sunriax/lamp/pcb/pcb.kicad_pcb

## KiCad design pcb/pcb.kicad_pcb (2021-07-28)

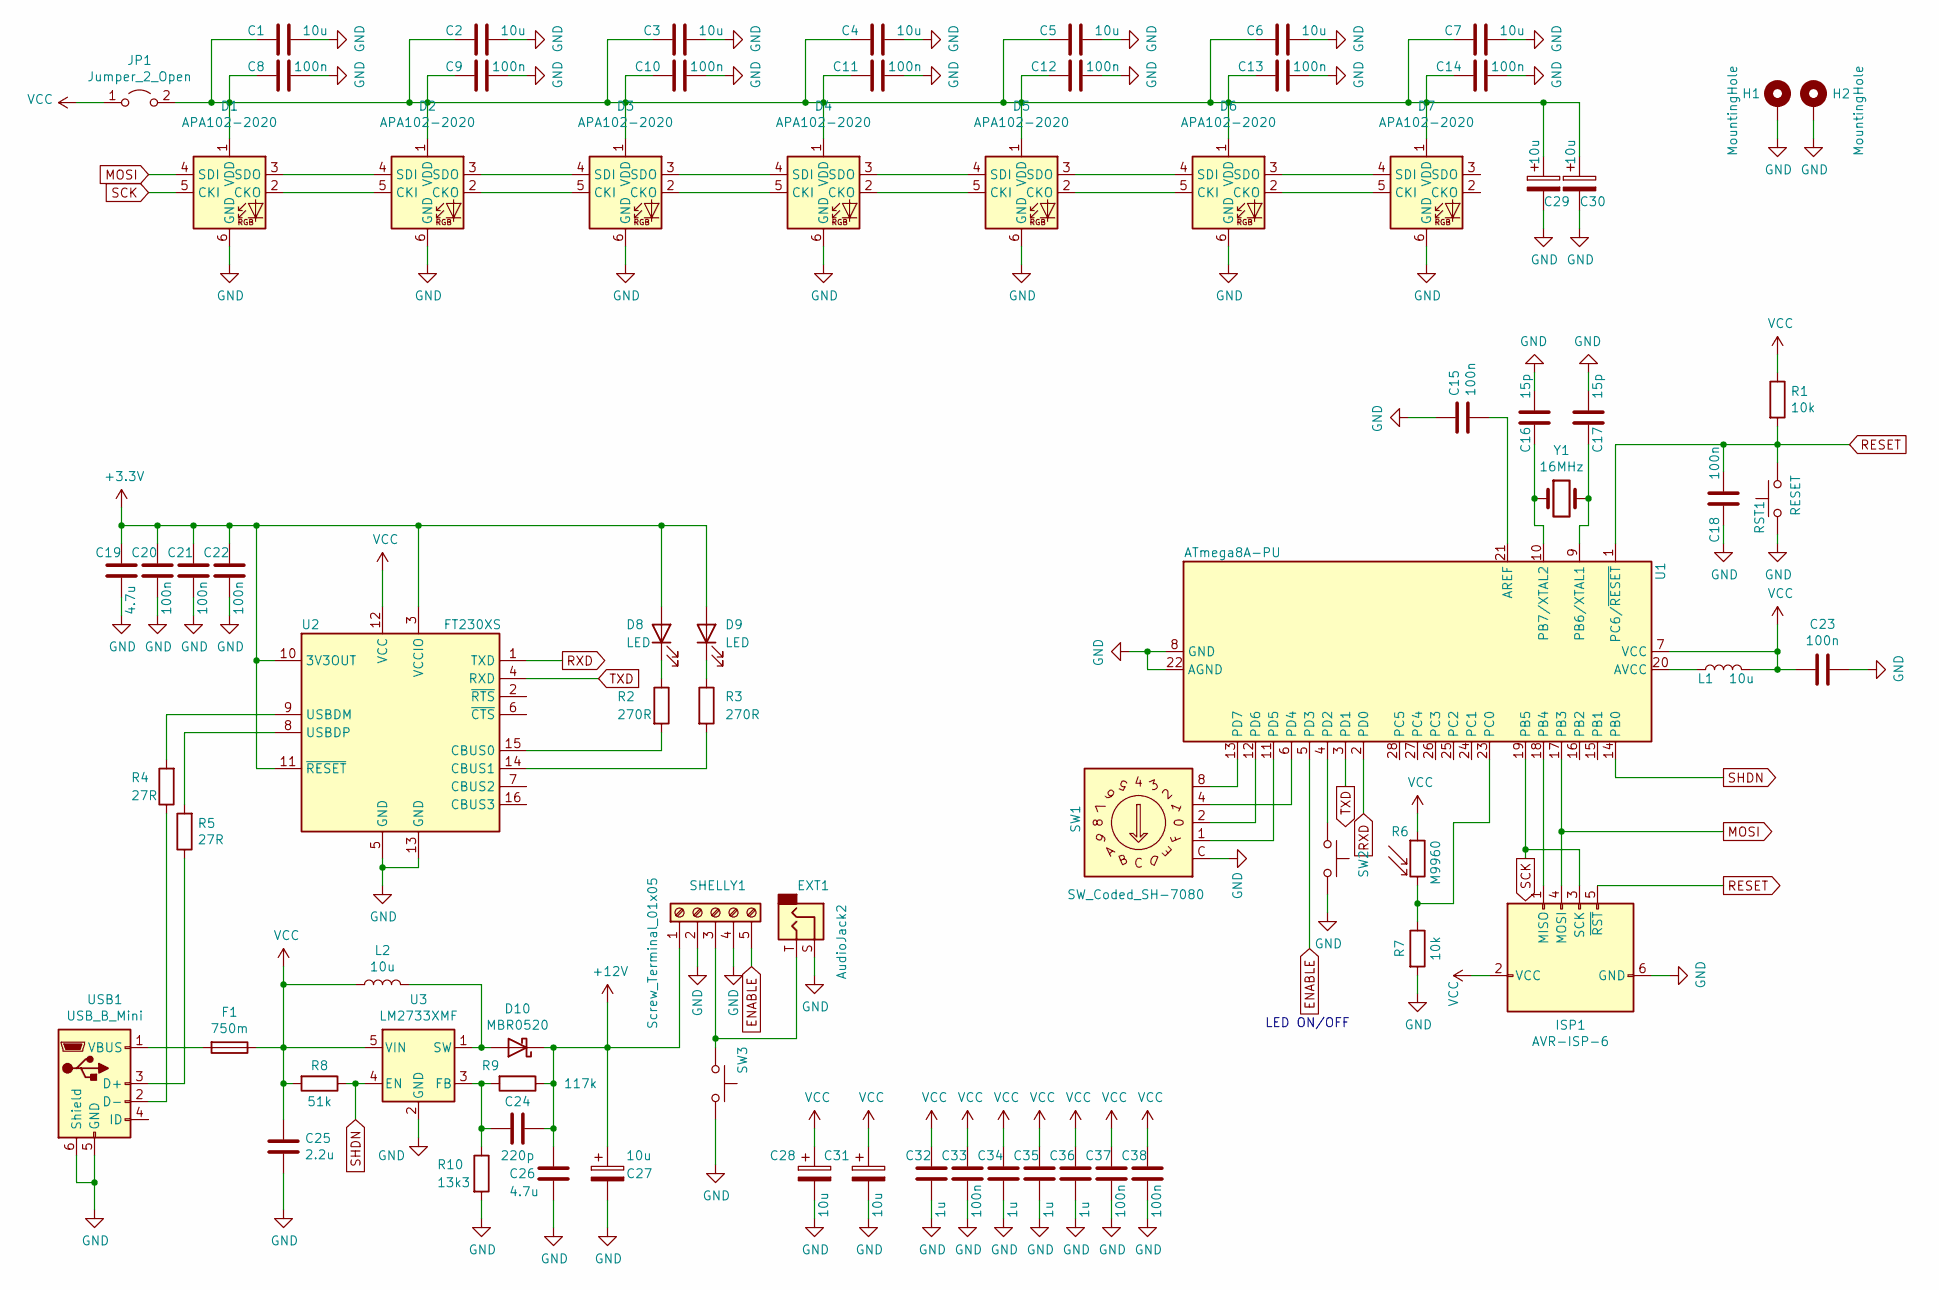
[picture p2: schematic pcb.sch, LED Controller]

Parts:
C1, C2, C3, C4, C5, C6, C7: 10u; C_0603_1608Metric
C8, C9, C10, C11, C12, C13, C14, C15, C18, C20, C21, C22, C23, C33, C37, C38: 100n; C_0603_1608Metric
C16, C17: 15p; C_0603_1608Metric
C19, C26: 4.7u; C_0603_1608Metric
C24: 220p; C_0603_1608Metric
C25: 2.2u; C_0603_1608Metric
C27, C28, C29, C30, C31: 10u; CP_Elec_4x5.8
C32, C34, C35, C36: 1u; C_0603_1608Metric
D1, D2, D3, D4, D5, D6, D7: APA102-2020; LED-APA102-2020
D8, D9: LED; LED_0603_1608Metric
D10: MBR0520; D_SOD-123
EXT1: AudioJack2; Jack_3.5mm_CUI_SJ-3523-SMT_Horizontal
F1: 750m; Fuse_Bourns_MF-SM_7.98x5.44mm
H1, H2: MountingHole; MountingHole_3.2mm_M3_Pad
ISP1: AVR-ISP-6; PinHeader_2x03_P2.54mm_Vertical_SMD
JP1: Jumper_2_Open; PinHeader_1x02_P2.54mm_Horizontal
L1: 10u; L_0805_2012Metric
L2: 10u; L_Bourns-SRN1060
R1, R7: 10k; R_0603_1608Metric
R2, R3: 270R; R_0603_1608Metric
R4, R5: 27R; R_0603_1608Metric
R6: M9960; R_LDR_5.2x5.2mm_P3.5mm_Horizontal
R8: 51k; R_0603_1608Metric
R9: 117k; R_0603_1608Metric
R10: 13k3; R_0603_1608Metric
RST1: RESET; SW_Push_1P1T-SH_NO_CK_KMR2xxG
SHELLY1: Screw_Terminal_01x05; TerminalBlock_Phoenix_MKDS-1,5-5_1x05_P5.00mm_Horizontal
SW1: SW_Coded_SH-7080; Nidec_Copal_SH-7040B
SW2, SW3: SW_Push_1P1T-SH_NO_CK_KMR2xxG
U1: ATmega8A-PU; DIP-28_W8.89mm_SMDSocket_LongPads
U2: FT230XS; SSOP-16_3.9x4.9mm_P0.635mm
U3: LM2733XMF; SOT-23-5
USB1: USB_B_Mini; USB_Mini-B_Lumberg_2486_01_Horizontal
Y1: 16MHz; Crystal_SMD_0603-2Pin_6.0x3.5mm

Connections:
+3V3: C19.2, C20.2, C21.2, C22.2, D8.2 (A), D9.2 (A), U2.3 (VCCIO), U2.10 (3V3OUT), U2.11 (~RESET)
+12V: C24.1, C26.1, C27.1, D10.1 (K), R9.1, SHELLY1.1
ENABLE: SHELLY1.5, U1.5 (PD3)
GND: C1.1, C2.1, C3.1, C4.1, C5.1, C6.1, C7.1, C8.1, C9.1, C10.1, C11.1, C12.1, C13.1, C14.1, C15.2, C16.2, C17.1, C18.2, C19.1, C20.1, C21.1, C22.1, C23.2, C25.2, C26.2, C27.2, C28.2, C29.2, C30.2, C31.2, C32.1, C33.1, C34.1, C35.1, C36.1, C37.1, C38.1, D1.6 (GND), D2.6 (GND), D3.6 (GND), D4.6 (GND), D5.6 (GND), D6.6 (GND), D7.6 (GND), EXT1.S, H1.1, H2.1, ISP1.6 (GND), R7.2, R10.2, RST1.1, SHELLY1.2, SHELLY1.4, SW1.C, SW2.1, SW3.1, U1.8 (GND), U1.22 (AGND), U2.5 (GND), U2.13 (GND), U3.2 (GND), USB1.5 (GND), USB1.6 (Shield)
MOSI: D1.4 (SDI), ISP1.4 (MOSI), U1.17 (PB3)
unnamed: C1.2, C2.2, C3.2, C4.2, C5.2, C6.2, C7.2, C8.2, C9.2, C10.2, C11.2, C12.2, C13.2, C14.2, C29.1, C30.1, D1.1 (VDD), D2.1 (VDD), D3.1 (VDD), D4.1 (VDD), D5.1 (VDD), D6.1 (VDD), D7.1 (VDD), JP1.2 (B)
unnamed: C15.1, U1.21 (AREF)
unnamed: C16.1, U1.10 (PB7/XTAL2), Y1.1
unnamed: C17.2, U1.9 (PB6/XTAL1), Y1.2
unnamed: C24.2, R9.2, R10.1, U3.3 (FB)
unnamed: D1.2 (CKO), D2.5 (CKI)
unnamed: D1.3 (SDO), D2.4 (SDI)
unnamed: D2.2 (CKO), D3.5 (CKI)
unnamed: D2.3 (SDO), D3.4 (SDI)
unnamed: D3.2 (CKO), D4.5 (CKI)
unnamed: D3.3 (SDO), D4.4 (SDI)
unnamed: D4.2 (CKO), D5.5 (CKI)
unnamed: D4.3 (SDO), D5.4 (SDI)
unnamed: D5.2 (CKO), D6.5 (CKI)
unnamed: D5.3 (SDO), D6.4 (SDI)
unnamed: D6.2 (CKO), D7.5 (CKI)
unnamed: D6.3 (SDO), D7.4 (SDI)
unnamed: D8.1 (K), R2.1
unnamed: D9.1 (K), R3.1
unnamed: D10.2 (A), L2.2, U3.1 (SW)
unnamed: EXT1.T, SHELLY1.3, SW3.2
unnamed: F1.2, USB1.1 (VBUS)
unnamed: ISP1.1 (MISO), U1.18 (PB4)
unnamed: L1.1, U1.20 (AVCC)
unnamed: R2.2, U2.15 (CBUS0)
unnamed: R3.2, U2.14 (CBUS1)
unnamed: R4.1, USB1.2 (D-)
unnamed: R4.2, U2.9 (USBDM)
unnamed: R5.1, USB1.3 (D+)
unnamed: R5.2, U2.8 (USBDP)
unnamed: R6.2, R7.1, U1.23 (PC0)
unnamed: SW1.1, U1.11 (PD5)
unnamed: SW1.2, U1.12 (PD6)
unnamed: SW1.4, U1.6 (PD4)
unnamed: SW1.8, U1.13 (PD7)
unnamed: SW2.2, U1.4 (PD2)
RESET: C18.1, ISP1.5 (~RST), R1.2, RST1.2, U1.1 (PC6/~RESET)
RXD: U1.2 (PD0), U2.1 (TXD)
SCK: D1.5 (CKI), ISP1.3 (SCK), U1.19 (PB5)
SHDN: R8.1, U1.14 (PB0), U3.4 (EN)
TXD: U1.3 (PD1), U2.4 (RXD)
VCC: C23.1, C25.1, C28.1, C31.1, C32.2, C33.2, C34.2, C35.2, C36.2, C37.2, C38.2, F1.1, ISP1.2 (VCC), JP1.1 (A), L1.2, L2.1, R1.1, R6.1, R8.2, U1.7 (VCC), U2.12 (VCC), U3.5 (VIN)

Notes on the sheet:
LED ON/OFF

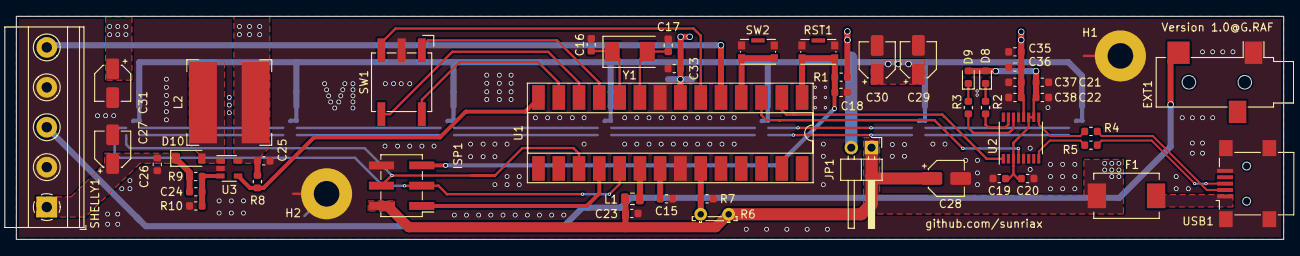
[picture p3: board pcb.kicad_pcb from above]

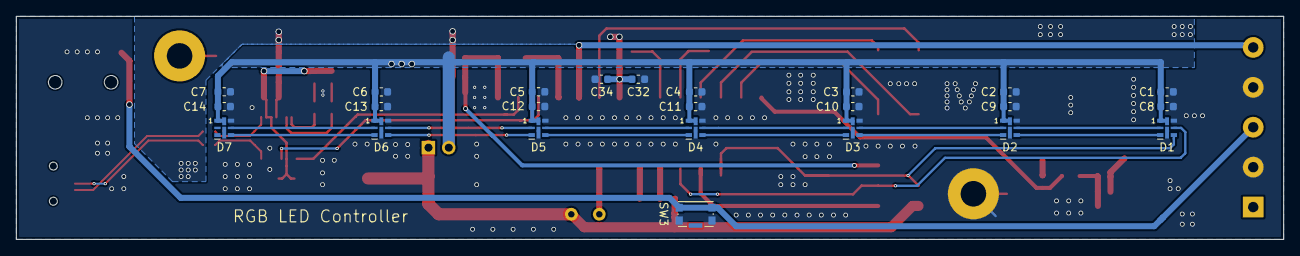
[picture p4: board pcb.kicad_pcb from below]

Board: 2 copper layers, 158.8 x 27.9 mm, 76 parts (24 on the bottom side), 47 nets.
